KynanDelaney/NicroCam/Datasheets/adafruit_powerboost_1000_schematic.png

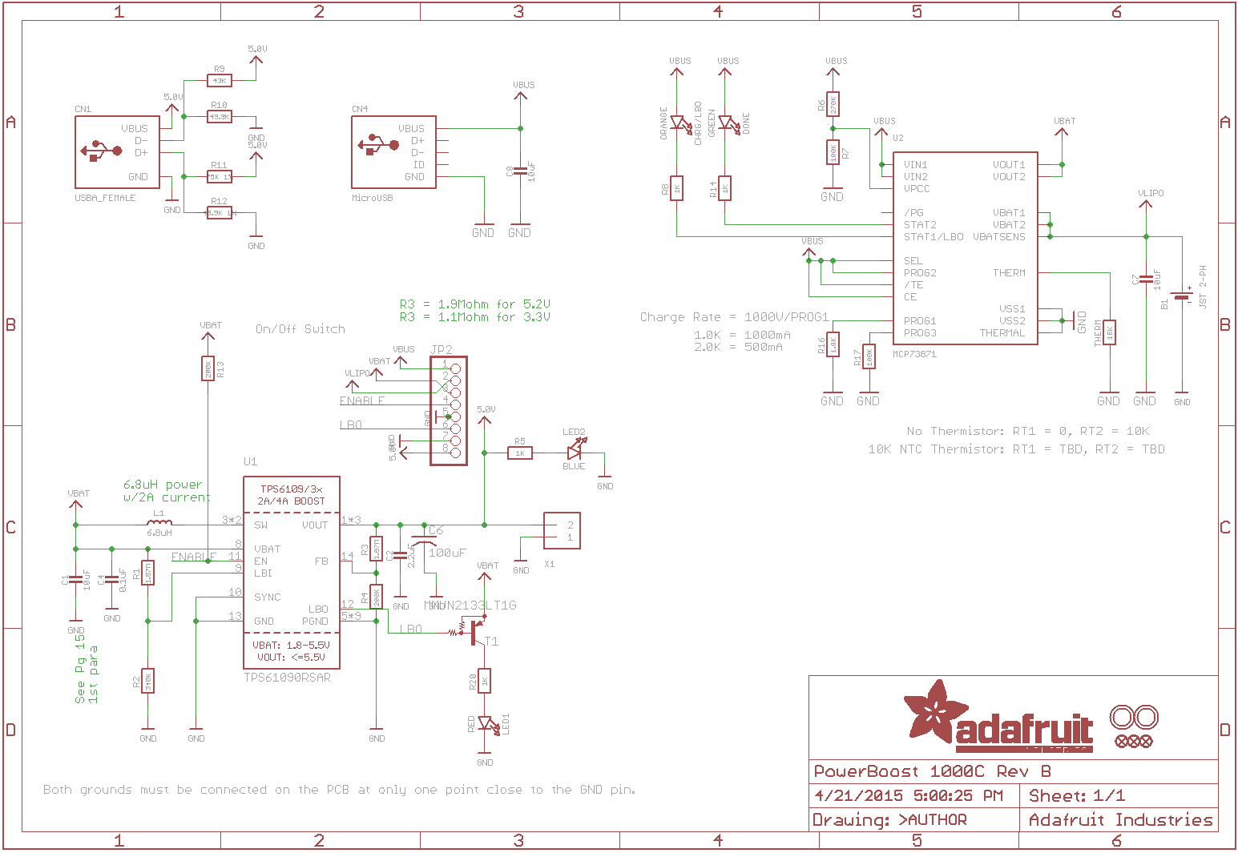
Datasheets/adafruit_powerboost_1000_schematic.png
