KynanDelaney/NicroCam/Datasheets/BOM_Prototype_Prototype camera board_2026-10-25.xlsx

No. | Quantity | Comment | Designator | Footprint | Value | Manufacturer Part | Manufacturer | Supplier Part | Supplier
1 | 5 | 22uF | C1,C3,C4,C5,C11 | C0805 | 22uF | CL21A226MAQNNNE | SAMSUNG(三星) | C45783 | LCSC
2 | 1 | 10nF | C2 | C0603 | 10nF | CC0603KRX7R9BB103 | YAGEO(国巨) | C100042 | LCSC
3 | 1 | 1uF | C6 | C0805 | 1uF | CL21B105KBFNNNE | SAMSUNG(三星) | C28323 | LCSC
4 | 1 | 1nF | C7 | C0805 | 1nF | FM21X102K501PXG | PSA(信昌电陶) | C440004 | LCSC
5 | 2 | 100nF | C8,C10 | C0805 | 100nF | FCC0805B104K500DT | FOJAN(富捷) | C5137467 | LCSC
6 | 1 | 10uF | C9 | C0805 | 10uF | CL21A106KAYNNNE | SAMSUNG(三星) | C15850 | LCSC
7 | 1 | B2B-PH-K-S | CN1 | CONN-TH_B2B-PH-K-S |  | B2B-PH-K-S | JST | C20504437 | LCSC
8 | 1 | Raspberry Pi Zero 2W with Header | H1 | Raspberry Pi Zero 2W Reverse
9 | 1 | Raspberry Pi Pico 2 WH | H2 | Raspberry Pi Pico 2 WH_Not_TP4_TP5 |  | Raspberry Pi Pico 2 WH | Raspberry Pi
10 | 1 | TMP36GT9 | H3 | TO-92-3_L4.2-W1.5-P1.27 |  | TMP36GT9 | ADI(亚德诺) | C3663440 | LCSC
11 | 1 | VL53L1X | H4 | VL53L1_Ail
12 | 1 | HDR-M_2.54_1x12P | H5 | HDR-TH_12P-P2.54-V-M
13 | 1 | Raspberry Pi Camera Module v2 | H-CAM | RASPBERRY PI CAMERA MODULE V2
14 | 1 | 1uH | L1 | IND-SMD_L4.0-W4.0_XFL4020-102MEB | 1uH | XFL4020-102MEC | Coilcraft(线艺) | C5355380 | LCSC
15 | 2 | LED_TH-R_5mm | LED1,LED2 | LED-TH_BD5.8-P2.54-FD
16 | 2 | SSM3J338R,LF | Q1,Q2 | SOT-23F_L2.9-W1.8-P0.95-LS2.4-BR |  | SSM3J338R,LF | TOSHIBA(东芝) | C146352 | LCSC
17 | 4 | 10kΩ | R1,R2,R4,R9 | R0805 | 10kΩ | 0805W8F1002T5E | UNI-ROYAL(厚声) | C17414 | LCSC
18 | 1 | 100kΩ | R3 | R0805 | 100kΩ | 0805W8F1003T5E | UNI-ROYAL(厚声) | C149504 | LCSC
19 | 1 | 1kΩ | R5 | R0805 | 1kΩ | 0805W8F1001T5E | UNI-ROYAL(厚声) | C17513 | LCSC
20 | 2 | 140Ω | R6,R7 | R1206 | 140Ω | FRC1206F1400TS | FOJAN(富捷) | C3013240 | LCSC
21 | 1 | 240Ω | R8 | R0603 | 240Ω | RC0603FR-07240RL | YAGEO(国巨) | C114613 | LCSC
22 | 1 | TPS61232DRCT | U1 | VSON-10_L3.0-W3.0-P0.50-TL-EP-TPS61232DRCR |  | TPS61232DRCT | TI(德州仪器) | C2070659 | LCSC
23 | 1 | TPS22918DBVT | U2 | SOT-23-6_L2.9-W1.6-P0.95-LS2.8-BR |  | TPS22918DBVT | TI(德州仪器) | C2680345 | LCSC
24 | 1 | TL817 | U3 | SOP-4_L6.5-W4.6-P2.54-LS10.3-TL |  | TL817 |  | C9900160454 | LCSC
