KynanDelaney/NicroCam/(commit log)

2026-10-23 Update README.md
    Lay out the current rationale of the project and considerations for PCB design
2026-10-23 uploading core datasheets for pcb components or schematics for similar commercial products
2026-10-25 added BoM, Gerber for boost converter evm board, and schematic of proposed pcb
    [BOM_Prototype_Prototype camera board_2026-10-25.xlsx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]
2026-10-25 Update README.md with current proposed schematic and BoM
2026-10-27 exported project schematics and gerber, and some extra datasheets
    [BOM_Prototype_Prototype camera board_2026-10-25.xlsx]
2026-10-27 Update README.mdupdate readme with gerber view
2026-10-27 Update BoM in readme
2026-10-27 update Bom and schematic image from most current changes
    changed r9 resistor value to 10k. Routed the PG pin from tps61232 to pico pin 20, co-opting 100k resistor r3 as a pullup to 3v3 rail
    [BOM_Prototype_Prototype camera board_2026-10-25.xlsx]
2026-10-27 updated gerber files for slight movements of traces away from high-frequency zone
2026-10-28 added annotated trace image for review purposes
2026-10-28 Update README.md with annotated trace image
